NainaliD/Deployable-Parallel-Manipulator/3 RPS Tape Mechanism/Images/PXL_20260930_065634494.jpg

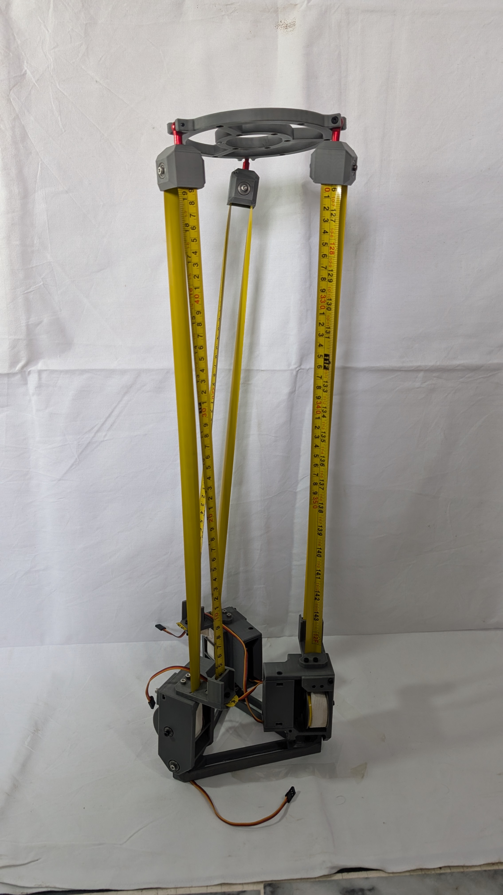
3 RPS Tape Mechanism/Images/PXL_20260930_065634494.jpg
