NainaliD/Deployable-Parallel-Manipulator/README.md

# Deployable-Parallel-Manipulator
This research is concerned on developing deployable manipulators for space missions and field robotics. The research focus on reducing the stowage volume requirements while enhancing the reach and dexterity of the manipulator. The approach uses motorized tape springs as prismatic links in parallel mechanism to achieve the mentioned objectives.
