NainaliD/Deployable-Parallel-Manipulator/3 RPS Tape Mechanism/Reports/Technical Summary.pdf

## Motorized Tape Springs as Prismatic Links in Deployable Parallel Mechanisms for Space Exploration Robots

Hasnain Ali
hasnainalidahri8@gmail.com

Background and Research Gap

Planetary exploration requires robots with long reach and compact stowage, creating a trade-off between stowage volume and workspace. Serial robots offer large workspaces, but require higher stowage volume. Parallel mechanisms provide higher stiffness, better load distribution, and compact actuator placement, but offer limited workspace (Antonov, 2024).
Tape springs can address this trade-off by rolling into compact coils and deploying as structural members (Tang et al., 2020; Ding et al., 2022). Recent studies demonstrate their use in long-reach, climbing, and extensible-bending robotic limbs (He et al., 2025; Morton et al., 2024; Quan & Hong, 2022; Quan et al., 2023). However, current research predominantly focuses on isolated, single-limb applications. Their integration into a parallel mechanism for mobility and manipulation remains underexplored. Tape-spring-based prismatic links in parallel mechanisms can potentially achieve compact stowage and extended reach.

Hypothesis

Motorized tape springs can replace the rigid prismatic links of a parallel mechanism, letting it extend far beyond its stowed size while still carrying and orienting a payload.

Prototyping and Testing

Prototype design. To test the hypothesis, a 3-RPS mechanism was developed using motorized tape springs as prismatic links. Three identical limbs join the base and the moving platform through revolute and ball joints (Fig. 1). Each limb has a tape blade, idle pulley, and motor-driven drum. As in EEMMMa-1 (Quan & Hong, 2022), the tape is folded into a U-shape over the pulley, so the two sections bend in opposite directions, increasing the stiffness and peak moment capacity. One tape end is fixed to the body, the other is wound onto the drum, and an elastic band keeps the tape taut. Turning the drum moves the pulley hub, providing prismatic motion. The parts are FDM-printed in PLA+ with MG945 servos. Off-the-shelf bearings and fasteners are used for assembly, and the tape blade is 16 mm commercial measuring tape. The total mass of the prototype is 627 g.

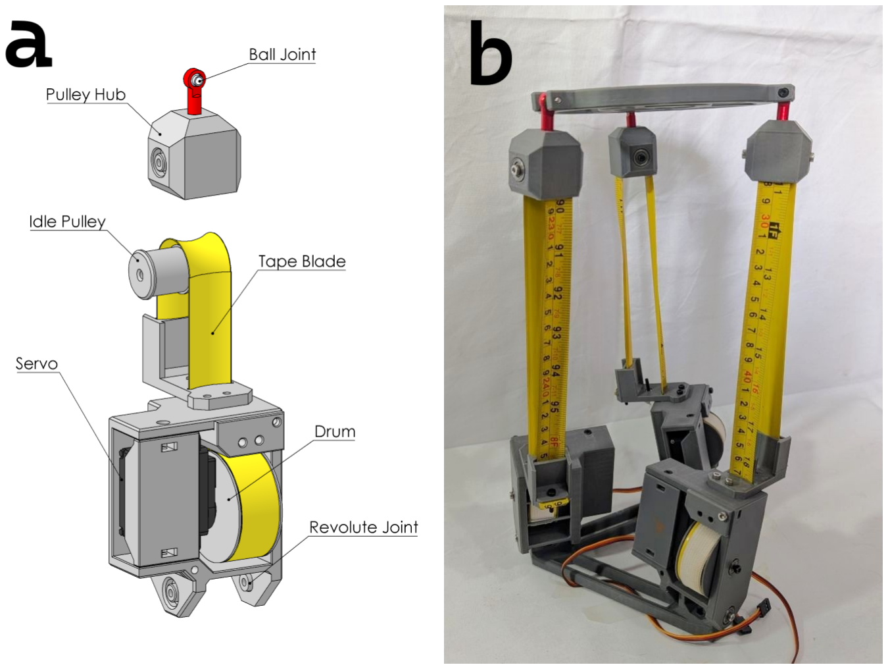
[picture p3: figure]

Fig. 1. The 3-RPS mechanism. (a) CAD view of one motorized tape-spring limb. (b) Assembled prototype.

Test method. The prototype was tested at effective tape-spring lengths of 10, 30, and 45 cm, with the platform level (0◦

inclination) and tilted to 20◦

. The inclination was limited to 20◦

to remain within the ±20◦
angular
range of the ball joints and avoid prestraining the tape springs. At each length, the tape springs were first extended to the set lengths, and the load was then applied to the platform. For the inclined tests, one limb was extended further to tilt the platform.
Loads of 0.5 kg and 1 kg were planned. Failure was defined as buckling of the tape springs. At 10 cm, both loads were tested. At 30 cm, the 1 kg load at 0◦
inclination caused failure, so the remaining tests at 30 cm and 45 cm used only the 0.5 kg load.

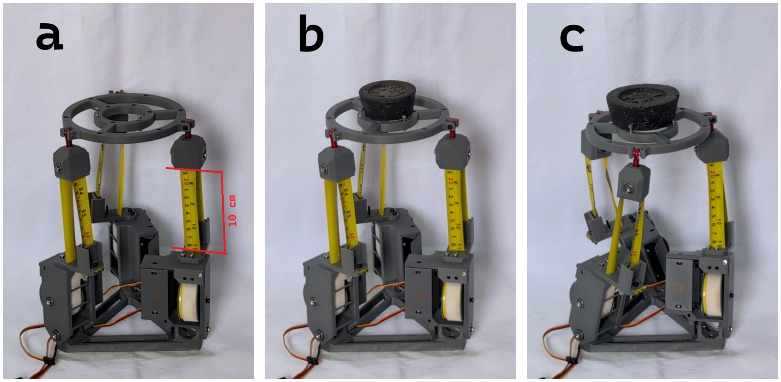
[picture p4: figure]
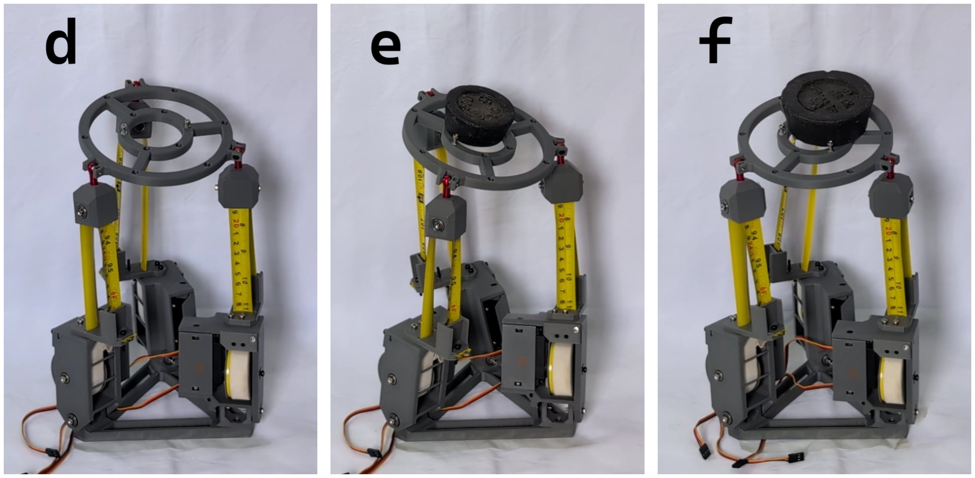
[picture p5: figure]

Fig. 2. Tests at 10 cm tape length. (a–c) Level platform; (d–f) platform tilted 20◦ . Each row: unloaded, 0.5 kg, 1 kg.

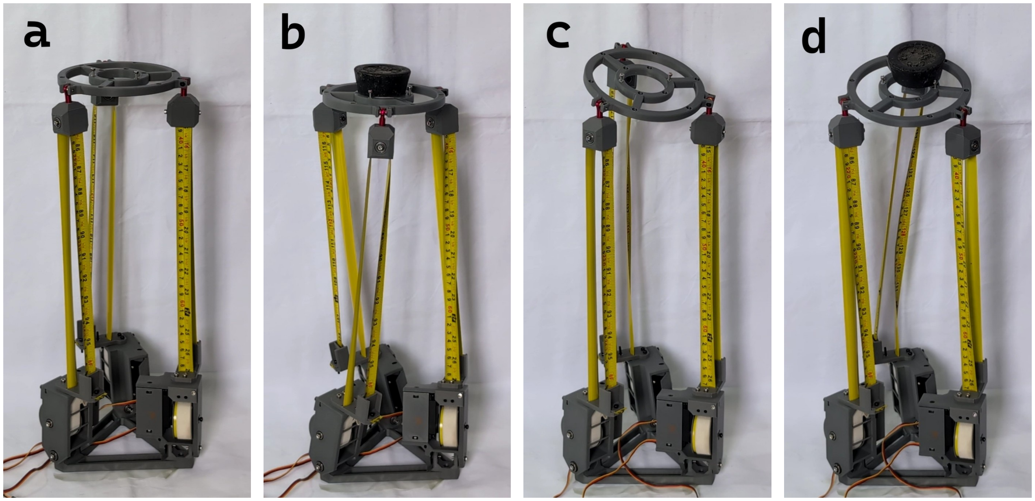
[picture p6: figure]

Fig. 3. Tests at 30 cm tape length. (a, b) Level platform: unloaded, 0.5 kg. (c, d) Platform tilted 20◦ : unloaded, 0.5 kg.

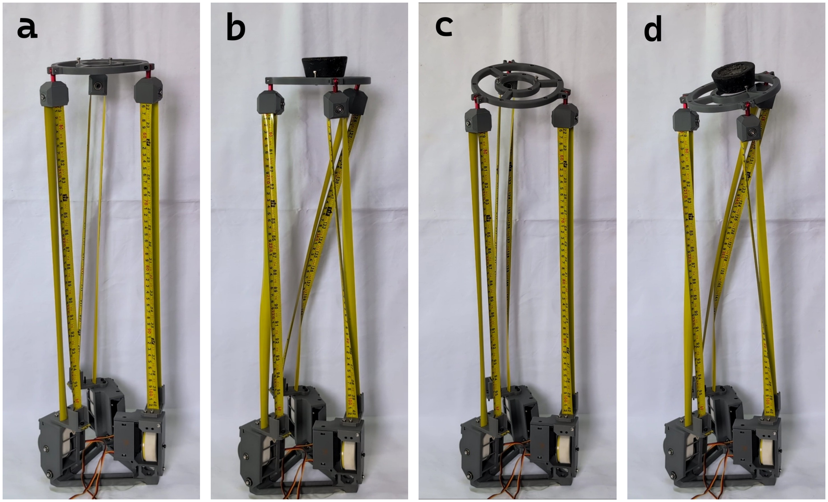
[picture p7: figure]

Fig. 4. Tests at 45 cm tape length. (a, b) Level platform: unloaded, 0.5 kg. (c, d) Platform tilted 20◦ : unloaded, 0.5 kg.

Discussion

The prototype demonstrates that tape springs can function as prismatic links in a parallel mechanism while revealing the limits of the design. At 10 cm extension, the mechanism remained stable under loads up to 1 kg, with only minor compliance at 20◦
inclination (Fig. 2). At 30 cm, it supported 0.5 kg at both orientations, but the 1 kg load caused tape-spring failure (Fig. 3). At 45 cm, it supported 0.5 kg at 20◦
inclination, but
the blades underwent substantial bending and twisting (Fig. 4). Although parasitic yaw persisted throughout testing, higher extensions and loads substantially magnified this torsional effect.
As a proof of concept, the prototype does not represent the overall capability of the approach, but shows that motorized tape springs can provide variable-length links in a parallel architecture. Further research should investigate engineered tape springs, improved joints, and alternative parallel configurations to increase reach, stability, and mobility with low stowage volume requirements.

References

Antonov, A. (2024). Parallel–serial robotic manipulators: A review of architectures, applications, and methods of design and analysis. Machines, 12(11), Article 811. https://doi.org/10.3390/machines12110811
Ding, T., Li, B., Liu, H., Peng, Y., & Yang, Y. (2022). Planar multi-closed-loop hyper-redundant manipulator using extendable tape springs: Design, modeling, and experiments. IEEE Robotics and Automation Letters, 7(3), 6630–6637. https: //doi.org/10.1109/LRA.2022.3176063
He, G., Sparks, C., & Gravish, N. (2025). Grasping and rolling in-plane manipulation using deployable tape spring appendages. Science Advances, 11(15), Article eadt5905. https://doi.org/10.1126/sciadv.adt5905
Morton, D., Cutkosky, M., & Pavone, M. (2024). Task-driven manipulation with reconfigurable parallel robots. arXiv. https://doi.org/10.48550/arXiv.2403.10768
Quan, J., & Hong, D. (2022). Extending and bending robotic limbs using tape springs for mobility and manipulation: Prelimi-nary investigations. In Proceedings of the ASME 2022 International Design Engineering Technical Conferences and Computers and Information in Engineering Conference. https://doi.org/10.1115/DETC2022-89431
Quan, J., Zhu, M., & Hong, D. (2023). A lightweight mobile robot for climbing steel structures with an extending and bending tape spring limb. In Proceedings of the ASME 2023 International Design Engineering Technical Conferences and Computers and Information in Engineering Conference. https://doi.org/10.1115/DETC2023-115048
Tang, Y., Zheng, H., Tang, L., Peng, Y., Pu, H., & Yang, Y. (2020). Design of a lightweight deployable planar parallel manipulator with tape spring mechanism. In Proceedings of the 4th International Workshop on Fundamental Issues, Applications and Future Research Directions for Parallel Mechanisms, Manipulators, and Machines.
