NainaliD/Deployable-Parallel-Manipulator/3 RPS Tape Mechanism/Images/2.jpg

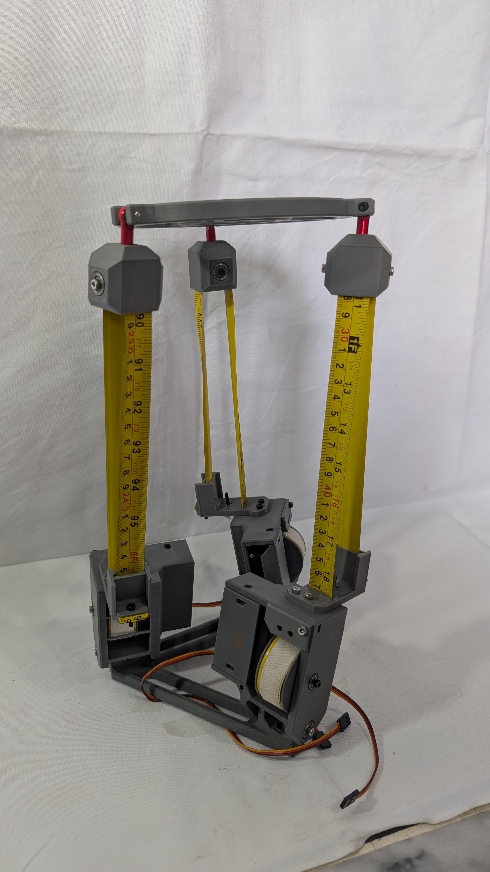
3 RPS Tape Mechanism/Images/2.jpg
