NainaliD/Deployable-Parallel-Manipulator/3 RPS Tape Mechanism/Images/10cm_0_0.jpg

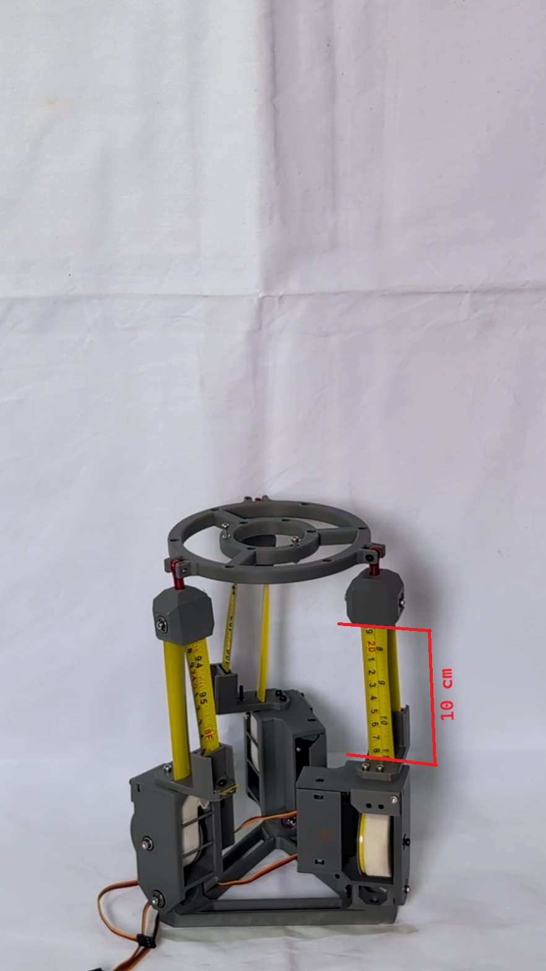
3 RPS Tape Mechanism/Images/10cm_0_0.jpg
