NainaliD/Deployable-Parallel-Manipulator/3 RPS Tape Mechanism/Images/30cm_20_0.5.jpg

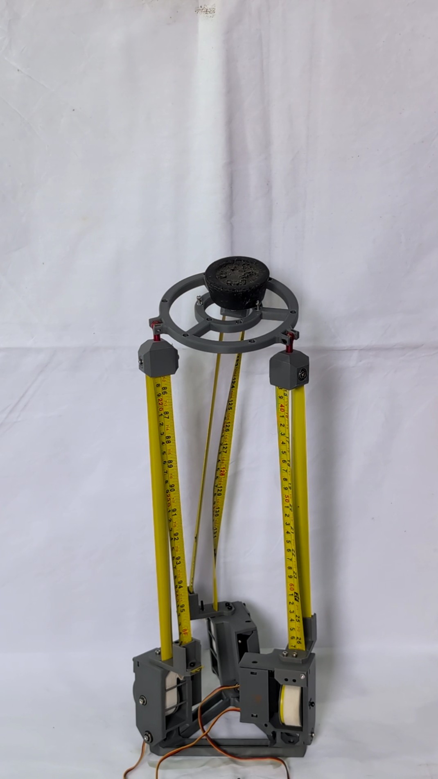
3 RPS Tape Mechanism/Images/30cm_20_0.5.jpg
