NainaliD/Deployable-Parallel-Manipulator/3 RPS Tape Mechanism/Images/DSC_0630.JPG

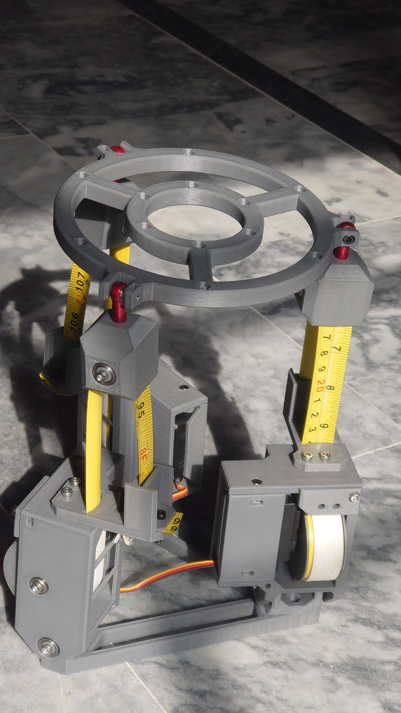
3 RPS Tape Mechanism/Images/DSC_0630.JPG
