NainaliD/Deployable-Parallel-Manipulator/3 RPS Tape Mechanism/Images/PXL_20260930_065917746.jpg

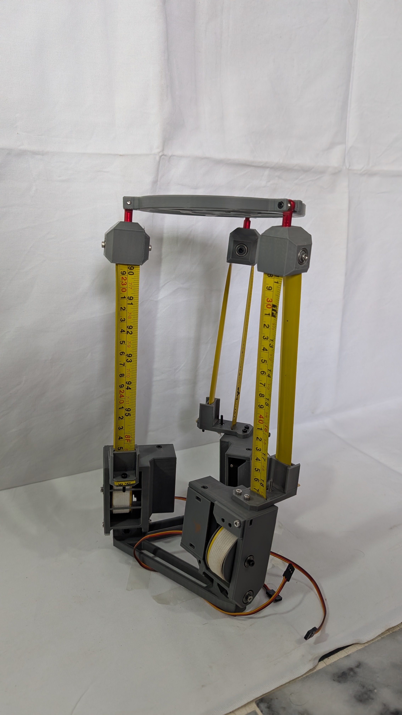
3 RPS Tape Mechanism/Images/PXL_20260930_065917746.jpg
