NainaliD/Deployable-Parallel-Manipulator/3 RPS Tape Mechanism/CAD/v1.STEP

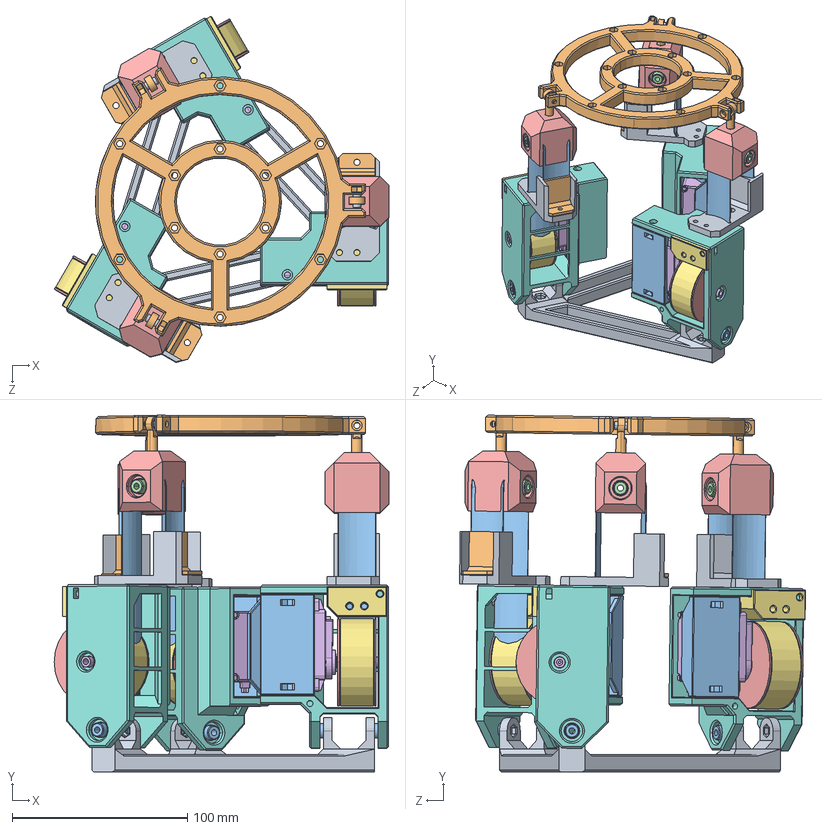
[picture p23: CAD file, 2026-10-21]
3 RPS Tape Mechanism/CAD/v1.STEP
191.2 x 203.8 x 197.7 mm
Base
Top Platform
PROP x 3
